myggen4444/SALMO/(commit log)

2026-04-28 Add files via upload
    la til all kode produsert i emne ttt4270 ved NTNU
2026-05-06 Add files via upload
    la til vedlegg om salinitetsensosren
